CuaDra2703/Almacenamiento/Cargador/Cargador comprado/Dimensiones.jpg

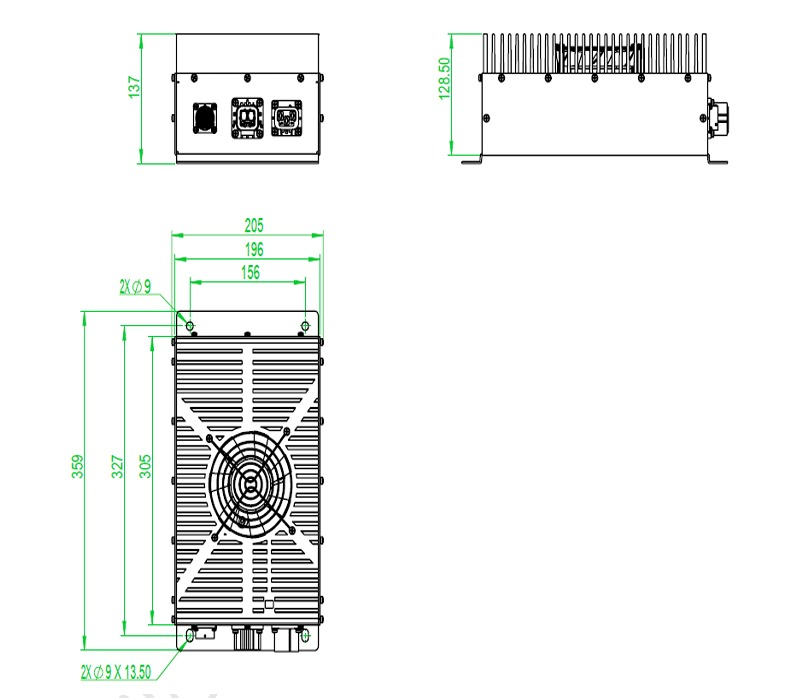
Cargador/Cargador comprado/Dimensiones.jpg
