CuaDra2703/Almacenamiento/Batería auxiliar/Cargador y componentes extras/Circulito/BMV-square-front-(stp) es cuadrado.step

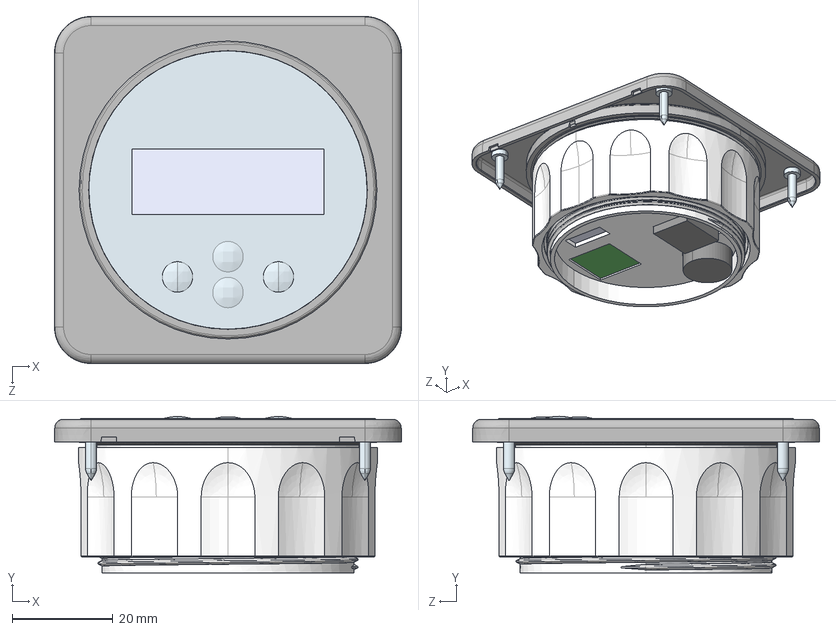
[picture p27: CAD file, 2024-04-13]
Batería auxiliar/Cargador y componentes extras/Circulito/BMV-square-front-(stp) es cuadrado.step
68.7 x 31.0 x 68.7 mm
V14.00.01 PCB
V14.00.02 Bottom Part Housing
V14.00.08 O ring
V14.00.05 Attachment Sleeve With Thread
V14.00.07 Front
V14.00.04 Overlay
V14.00.03 Front part of Housing
V14.00.09 Screw x 4
V14.xx.xx Glue Thickness
