CuaDra2703/Almacenamiento/Batería auxiliar/Cargador y componentes extras/Circulito/Shunt-500A50mV-(step).STEP

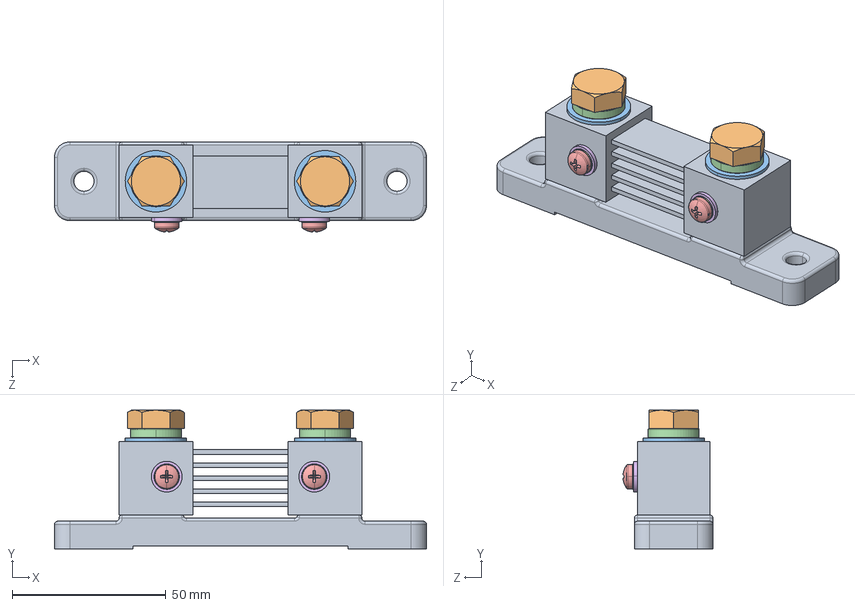
[picture p28: CAD file, 2024-04-13]
Batería auxiliar/Cargador y componentes extras/Circulito/Shunt-500A50mV-(step).STEP
121.0 x 45.1 x 29.3 mm
shunt500-rev01
hex cap screw_am_B18.2.3.1M - Hex cap screw, M10 x 1.5 x 16 --16C x 2
BrassM10RingShunt x 2
StainlessSteelM10SpringRingShunt x 2
pan cross head_am_B18.6.7M - M4 x 0.7 x 6 Type I Cross Recessed PHMS --6N x 2
flat washer narrow_am_B18.22M - Plain washer, 4 mm, narrow x 2
internal tooth lock washer_am_B18.21.2M-Internal Tooth Lock Washers_AM4 x 2
