CuaDra2703/Almacenamiento/Batería auxiliar/Cargador y componentes extras/Circulito/Shunt_for_BMV7xx-3D[1].STEP

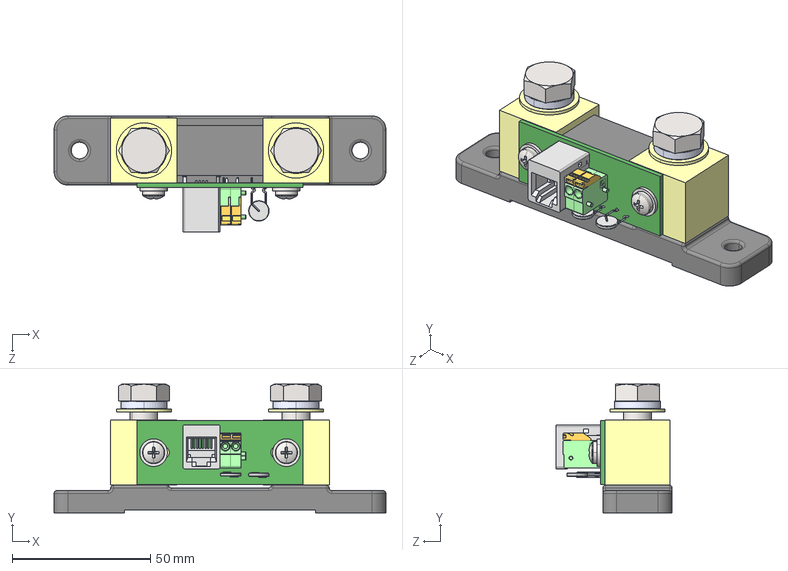
[picture p29: CAD file, 2024-04-13]
Batería auxiliar/Cargador y componentes extras/Circulito/Shunt_for_BMV7xx-3D[1].STEP
120.0 x 46.5 x 42.0 mm
shunt
hex cap screw_am_B18.2.3.1M - Hex cap screw, M10 x 1.5 x 16 --16C x 2
BrassM10RingShunt x 2
StainlessSteelM10SpringRingShunt x 2
shunt pcb
RXE020 x 2
pan cross head_am_B18.6.7M - M4 x 0.7 x 8 Type I Cross Recessed PHMS --8N x 2
flat washer narrow_am_B18.22M - Plain washer, 4 mm, narrow x 2
