CuaDra2703/Almacenamiento/Batería auxiliar/Cargador y componentes extras/Circulito/BMV-round-front-(stp)es circular.step

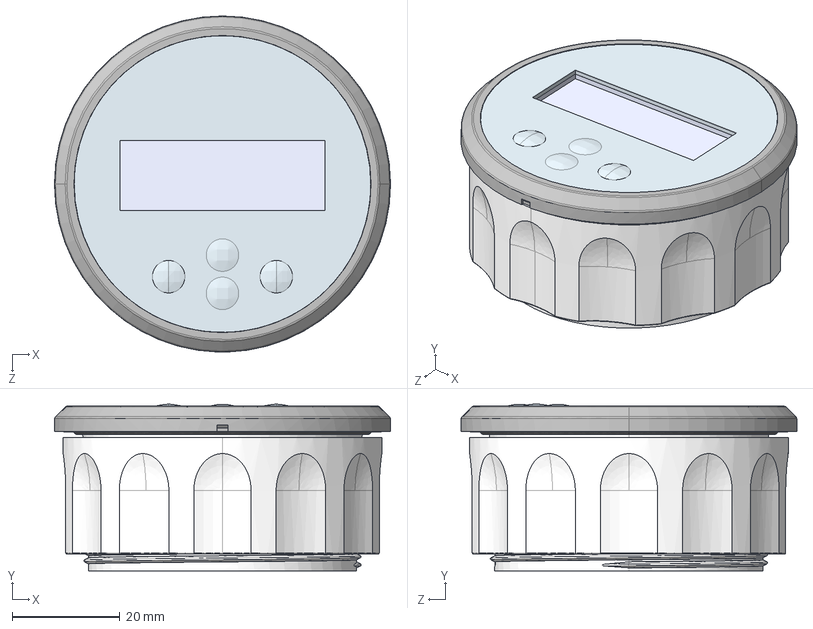
[picture p30: CAD file, 2024-04-13]
Batería auxiliar/Cargador y componentes extras/Circulito/BMV-round-front-(stp)es circular.step
62.4 x 31.0 x 62.4 mm
V14.00.01 PCB
V14.00.02 Bottom Part Housing
V14.00.08 O ring
V14.00.05 Attachment Sleeve With Thread
V14.00.04 Overlay
V14.00.03 Front part of Housing
V14.xx.xx Glue Thickness
