CuaDra2703/Almacenamiento/Batería auxiliar/Cargador y componentes extras/BMS/DimensionDrawing-VE.bus-BMS-V2.pdf

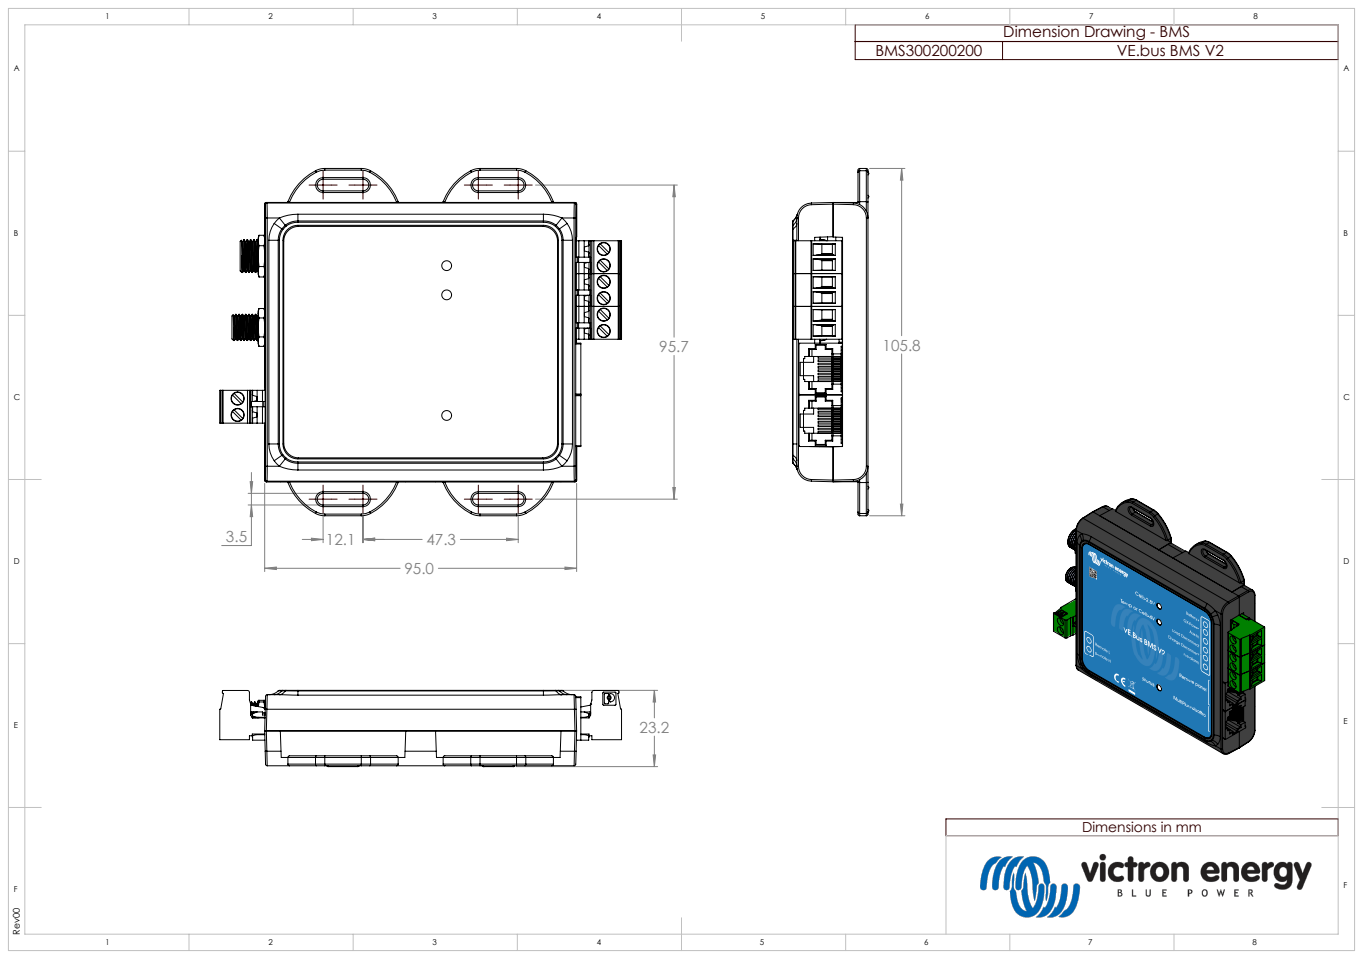
[picture p31: page 1]

Dimension Drawing - BMS

BMS300200200 | VE.bus BMS V2

Dimensions in mm
