CuaDra2703/Almacenamiento/Batería auxiliar/Cargador y componentes extras/cargador/Orion-Tr-Smart-Charger-Isolated-24V-400W.pdf

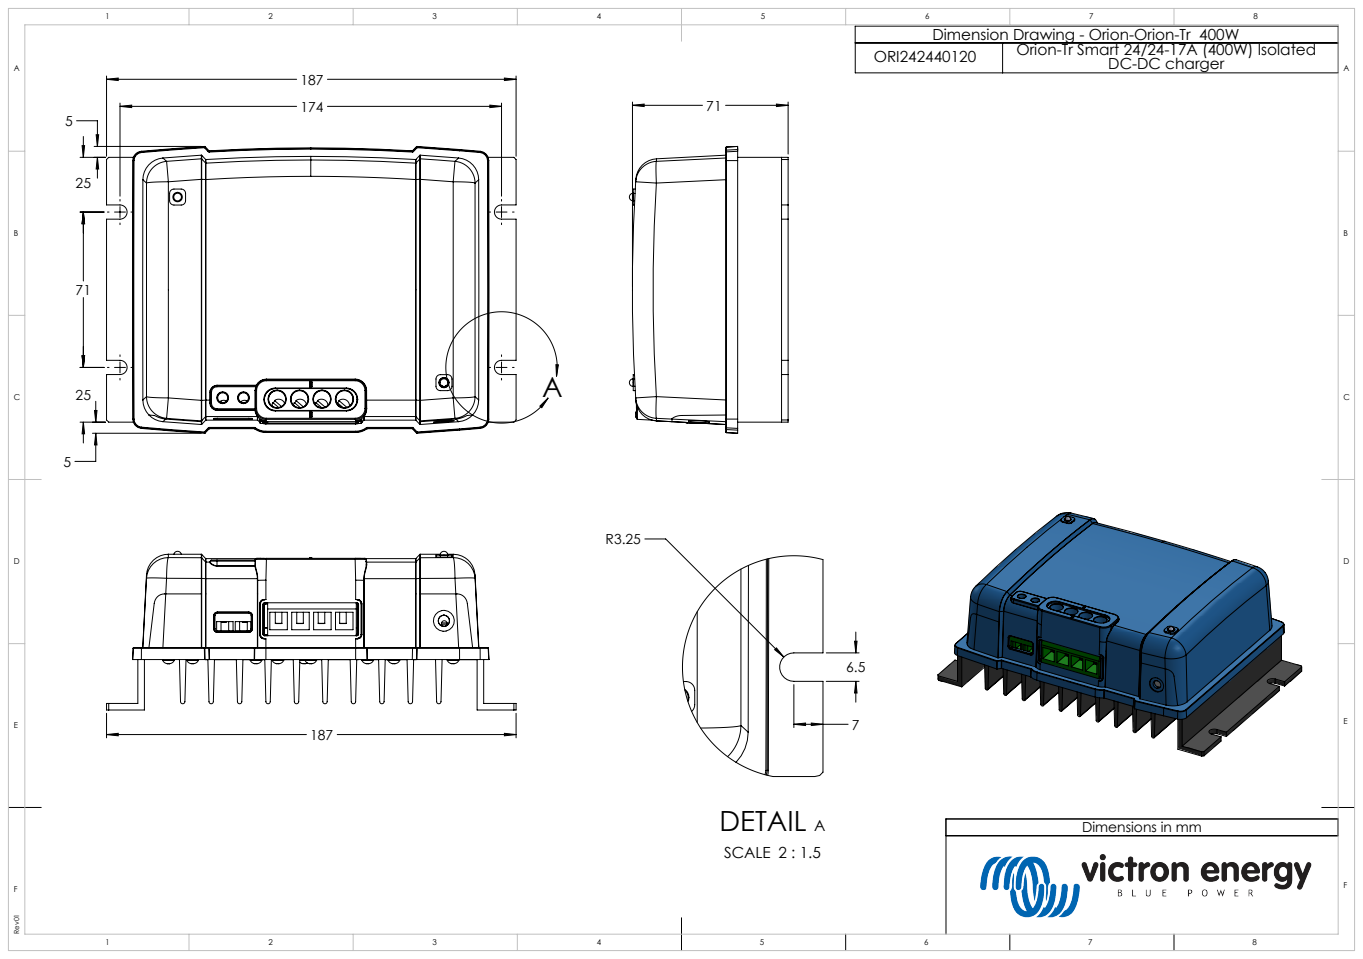
[picture p32: page 1]
DETAIL A; SCALE 2 : 1.5; Rev01; ORI242440120; Orion-Tr Smart 24/24-17A (400W) Isolated

Dimension Drawing - Orion-Orion-Tr 400W

DC-DC charger

Dimensions in mm
