CuaDra2703/Almacenamiento/Batería auxiliar/Cargador y componentes extras/Pantalla touch/GX-Touch-50 Dimensiones.pdf

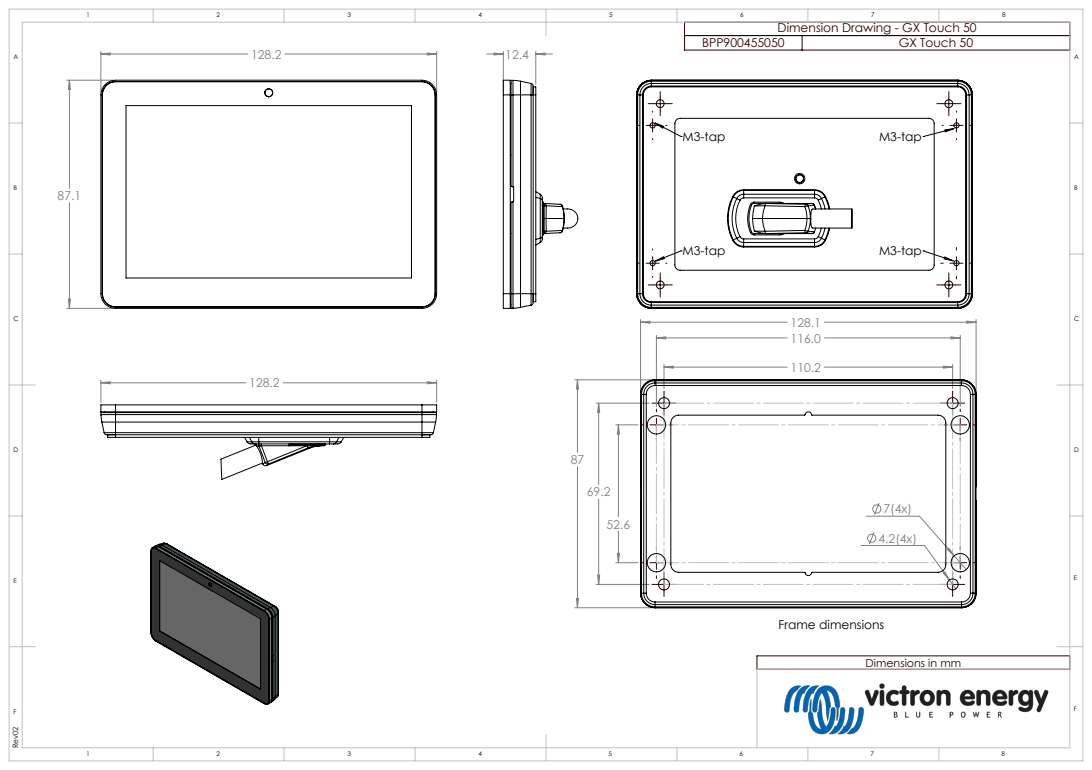
[picture p33: page 1]
Frame dimensions

Dimension Drawing - GX Touch 50

BPP900455050 | GX Touch 50

Dimensions in mm
