CuaDra2703/Almacenamiento/Batería auxiliar/Cargador y componentes extras/Cerebro/Cerbo-GX Dimensiones.pdf

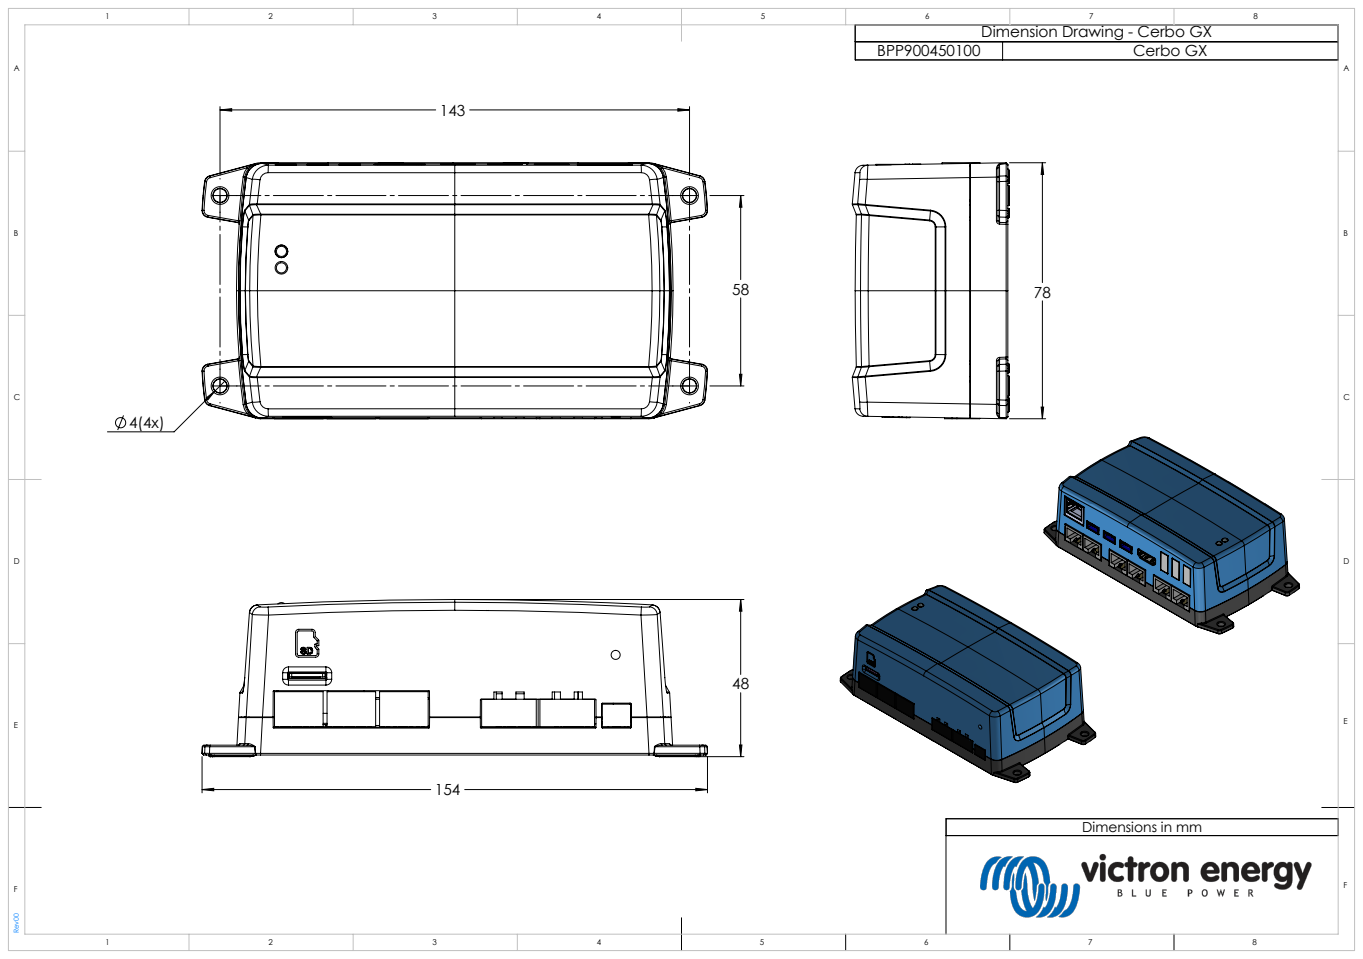
[picture p34: page 1]

Dimension Drawing - Cerbo GX

BPP900450100 | Cerbo GX

Dimensions in mm
