CuaDra2703/Almacenamiento/Batería auxiliar/Cargador y componentes extras/Circulito/Shunt-500A50mV.pdf

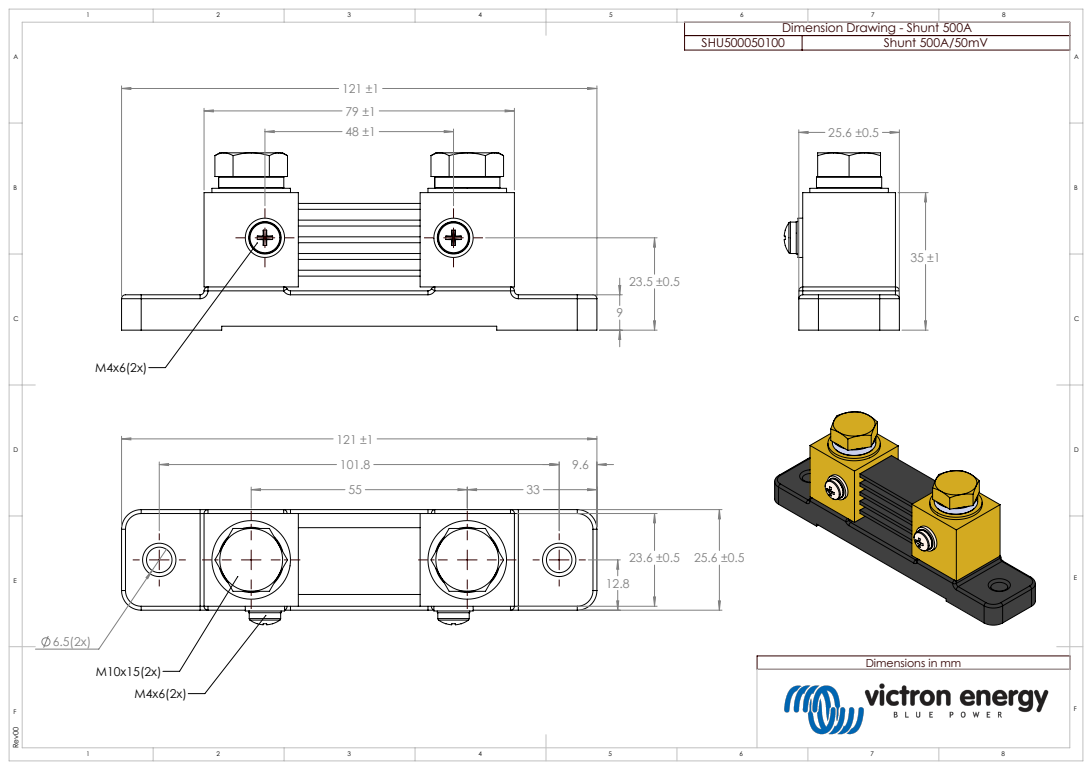
[picture p35: page 1]

Dimension Drawing - Shunt 500A

SHU500050100 | Shunt 500A/50mV

Dimensions in mm
