CuaDra2703/Almacenamiento/(commit log)

2024-04-08 Primer informe de la batería
2024-04-08 Información general de las celdas de litio
2024-04-13 Actualización de la batería
    [BMV-round-front-(stp)es circular.step, BMV-square-front-(stp) es cuadrado.step, Shunt-500A50mV-(step).STEP, Shunt_for_BMV7xx-3D[1].STEP]
